robbinsrush/4698LEDBadge/Badge-Schematic.pdf

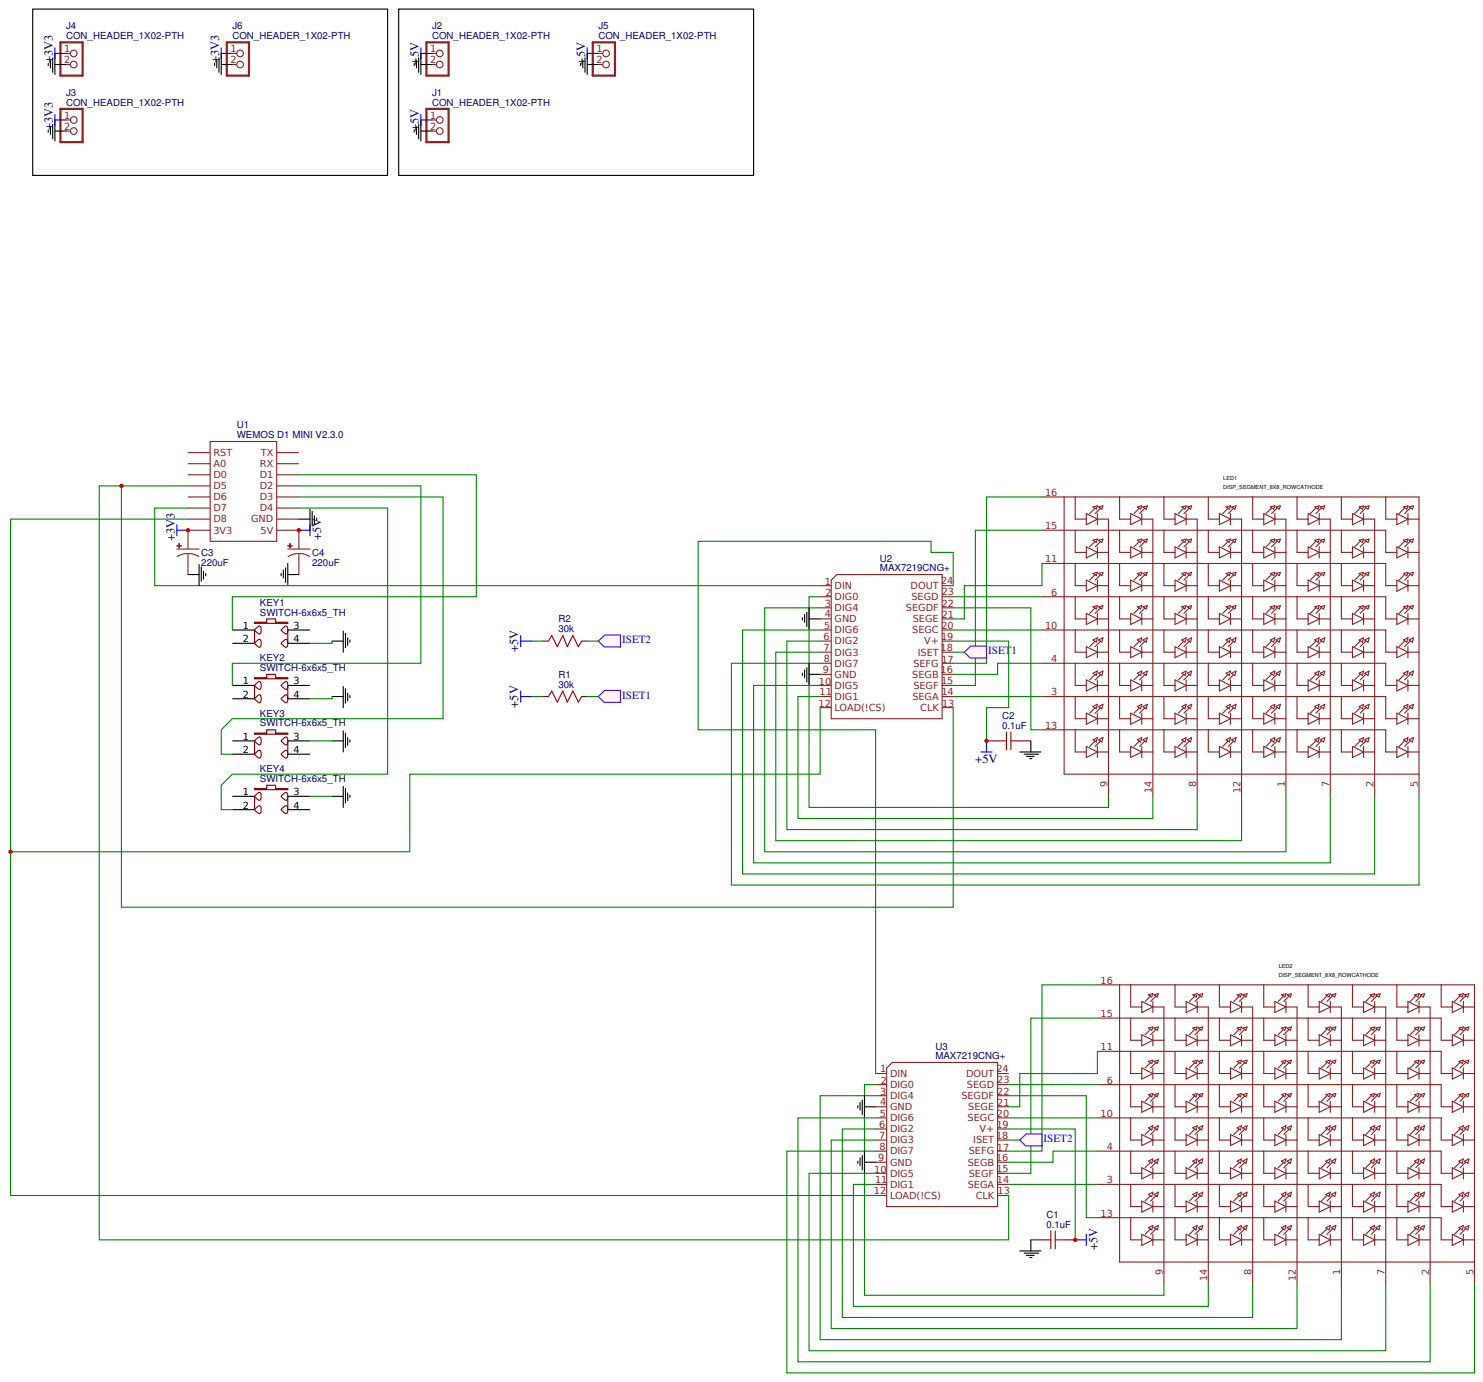
[picture p1: page 1]

ISET1 4 3
