robbinsrush/4698LEDBadge/LedMatrix.cpp

#include <SPI.h>
#include "LedMatrix.h"
#include "gfxfont.h"

/**
 * Heavily influenced by the code and the blog posts from https://github.com/nickgammon/MAX7219_Dot_Matrix
 */
LedMatrix::LedMatrix(byte numberOfDevices, byte slaveSelectPin) {
    myNumberOfDevices = numberOfDevices;
    mySlaveSelectPin = slaveSelectPin;
    cols = new byte[numberOfDevices * 8];
}

/**
 *  numberOfDevices: how many modules are daisy changed togehter
 *  slaveSelectPin: which pin is controlling the CS/SS pin of the first module?
 */
void LedMatrix::init() {
    pinMode(mySlaveSelectPin, OUTPUT);
    
    SPI.begin ();
    SPI.setDataMode(SPI_MODE0);
    SPI.setClockDivider(SPI_CLOCK_DIV128);
    for(byte device = 0; device < myNumberOfDevices; device++) {
        sendByte (device, MAX7219_REG_SCANLIMIT, 7);   // show all 8 digits
        sendByte (device, MAX7219_REG_DECODEMODE, 0);  // using an led matrix (not digits)
        sendByte (device, MAX7219_REG_DISPLAYTEST, 0); // no display test
        sendByte (device, MAX7219_REG_INTENSITY, 0);   // character intensity: range: 0 to 15
        sendByte (device, MAX7219_REG_SHUTDOWN, 1);    // not in shutdown mode (ie. start it up)
    }
    letterSize = sizeof(gfx_font[0]);
}

void LedMatrix::sendByte (const byte device, const byte reg, const byte data) {
    int offset=device;
    int maxbytes=myNumberOfDevices;
    
    for(int i=0;i<maxbytes;i++) {
        spidata[i] = (byte)0;
        spiregister[i] = (byte)0;
    }
    // put our device data into the array
    spiregister[offset] = reg;
    spidata[offset] = data;
    // enable the line
    digitalWrite(mySlaveSelectPin,LOW);
    // now shift out the data
    for(int i = myNumberOfDevices-1; i >= 0; i--){
        SPI.transfer (spiregister[i]);
        SPI.transfer (spidata[i]);
    }
    digitalWrite (mySlaveSelectPin, HIGH);   
}

void LedMatrix::sendByte (const byte reg, const byte data) {
    for(byte device = myNumberOfDevices-1; device > 0; device--) {
        sendByte(device, reg, data);
    }
}

void LedMatrix::setIntensity(const byte intensity) {
    for(byte device = 0; device < myNumberOfDevices; device++) {
        sendByte (device, MAX7219_REG_INTENSITY, intensity);   // character intensity: range: 0 to 15
    }
}

void LedMatrix::setCharWidth(byte charWidth) {
    myCharWidth = charWidth;
}

void LedMatrix::setTextAlignment(byte textAlignment) {
    myTextAlignment = textAlignment;
    calculateTextAlignmentOffset();
}

void LedMatrix::calculateTextAlignmentOffset() {
    switch(myTextAlignment) {
        case TEXT_ALIGN_LEFT:
        myTextAlignmentOffset = 0;
        break;
        case TEXT_ALIGN_LEFT_END:
        myTextAlignmentOffset = myNumberOfDevices * 8;
        break;
        case TEXT_ALIGN_RIGHT:
        myTextAlignmentOffset = myText.length() * myCharWidth - myNumberOfDevices * 8;
        break;
        case TEXT_ALIGN_RIGHT_END:
        myTextAlignmentOffset = - myText.length() * myCharWidth;
        break;
    }
    
}

void LedMatrix::clear() {
    for (byte col = 0; col < myNumberOfDevices * 8; col++) {
        cols[col] = 0;
    }
    
}

void LedMatrix::commit() {
    int max = myNumberOfDevices * 8;
    for (byte col = 0; col < max; col++) {
        if(upsideDown){
            sendByte(col / 8, col % 8 + 1, cols[(max-1)-col]);
        } else {
            sendByte(col / 8, col % 8 + 1, cols[col]);
        }
    }
}

void LedMatrix::setText(String text) {
    myText = text;
    myTextOffset = 0;
    calculateTextAlignmentOffset();
}

void LedMatrix::setNextText(String nextText) {
    myNextText = nextText;
}

String LedMatrix::reverseString(String toRev){
    int length = toRev.length();
    String reversed = toRev;

    for (int i = 0; i < length; i++){
      reversed[i] = toRev[(length-1)-i];
  }
  return reversed;
}

void LedMatrix::scrollTextRight() {
    //myTextOffset = (myTextOffset + 1) % ((int)myText.length() * myCharWidth - 5);
    myTextOffset = (myTextOffset + 1) % ((int)myText.length() * myCharWidth + myNumberOfDevices * 8);
    if (myTextOffset == 0 && myNextText.length() > 0) {
        myText = myNextText;
        myNextText = "";
        calculateTextAlignmentOffset();
    }
}

void LedMatrix::scrollTextLeft() {
    myTextOffset = (myTextOffset - 1) % ((int)myText.length() * myCharWidth + myNumberOfDevices * 8);
    if (myTextOffset == 0 && myNextText.length() > 0) {
        myText = myNextText;
        myNextText = "";
        calculateTextAlignmentOffset();
    }
}

void LedMatrix::oscillateText() {
    int maxColumns = (int)myText.length() * myCharWidth;
    int maxDisplayColumns = myNumberOfDevices * 8;
    if (maxDisplayColumns > maxColumns) {
        return;
    }
    if (myTextOffset - maxDisplayColumns == -maxColumns) {
        increment = 1;
    }
    if (myTextOffset == 0) {
        increment = -1;
    }
    myTextOffset += increment;
}

void LedMatrix::drawText() {
    char letter;
    int position = 0;
    for (int i = 0; i < myText.length(); i++) {
        letter = myText.charAt(i);
        for (byte col = 0; col < letterSize; col++) {
            position = i * myCharWidth + col + myTextOffset + myTextAlignmentOffset;
            if (position >= 0 && position < myNumberOfDevices * 8) {
                setColumn(position, pgm_read_byte (&gfx_font [letter] [col]));
            }
        }
    }
}

void LedMatrix::setColumn(int column, byte value) {
    if (column < 0 || column >= myNumberOfDevices * 8) {
        return;
    }

    if(upsideDown){
        // http://forum.arduino.cc/index.php?topic=54304.msg388532#msg388532
        value = ((value * 0x0802LU & 0x22110LU) | (value * 0x8020LU & 0x88440LU)) * 0x10101LU >> 16;
    }
    
    cols[column] = value;
}

void LedMatrix::setPixel(byte x, byte y, bool state) {
    if(upsideDown){
        bitWrite(cols[x], 7-y, state);
    } else {
        bitWrite(cols[x], y, state);
    }
}

void LedMatrix::setUpsideDown(bool state){
    upsideDown = state;
    //setTextAlignment(1);
}
