robbinsrush/4698LEDBadge/(commit log)

2018-03-04 Update LedMatrix.cpp with font and order change
2018-03-05 well arduino doesnt like numbers in the beginning of folders
2018-03-06 Turn on LED when in setup
2018-03-11 Fix setPixel() y offset for upside-down operation
    [LedMatrix.cpp]
2018-03-12 Chrome Dino-like game "Avoid" added!
    [Team4698Badge.ino]
2018-03-13 Added button() and added game reset with button push
    [Team4698Badge.ino]
